hexafraction/tencent/tencm.kicad_pcb

## KiCad design tencm.kicad_pcb (2017-06-22)

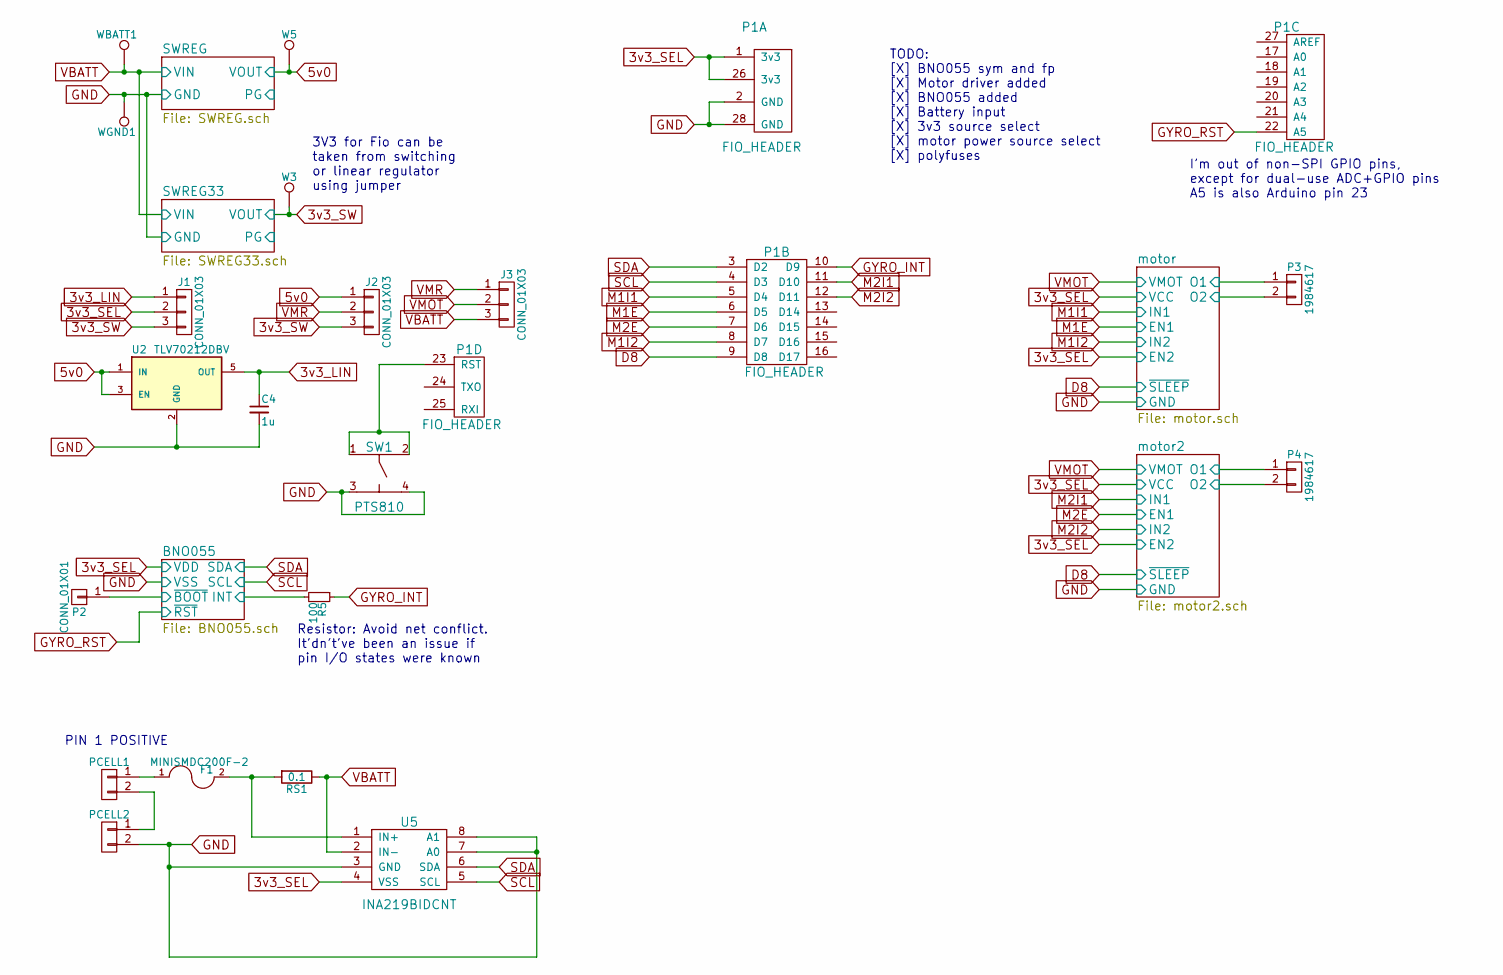
[picture p1: schematic tencm.sch]

Parts:
C4: 1u; C_0603
F1: MINISMDC200F-2; R_1812_HandSoldering
J1, J2, J3: CONN_01X03; Pin_Header_Straight_1x03
P1: FIO_HEADER; FIO_DIP
P2: CONN_01X01; Pin_Header_Straight_1x01
P3, P4: 1984617; TerminalBlock_Pheonix_PT-3.5mm_2pol
PCELL1, PCELL2: S2B-PH-K-S(LF)(SN); Connectors_JST_S2B-PH-K
R5: 100; R_0603
RS1: 0.1; MF_Passives-R1206
SW1: PTS810; BTN_PTS_810
U2: TLV70212DBV; MF_IC_Power-SOT-23-5
U5: INA219BIDCNT; sot23-8
W3, W5: TEST_1P; Measurement_Point_Round-TH_Small
WBATT1: TEST_1P; Measurement_Point_Round-TH_Small
WGND1: TEST_1P; Measurement_Point_Round-TH_Small

Connections:
3v3_LIN: C4.1, J1.1, U2.5 (OUT)
3v3_SEL: J1.2, P1.1 (3v3), P1.26 (3v3), U5.4 (VSS); also elsewhere on the board
3v3_SW: J1.3, J2.3, W3.1; also elsewhere on the board
5v0: J2.1, U2.1 (IN), U2.3 (EN), W5.1; also elsewhere on the board
/BNO055/INT: R5.2; also elsewhere on the board
/BNO055/~BOOT: P2.1; also elsewhere on the board
/motor2/O1: P4.1; also elsewhere on the board
/motor2/O2: P4.2; also elsewhere on the board
/motor/O1: P3.1; also elsewhere on the board
/motor/O2: P3.2; also elsewhere on the board
D8: P1.9 (D8); also elsewhere on the board
GGND: C4.2, P1.2 (GND), P1.28 (GND), PCELL2.2, SW1.3, SW1.4, U2.2 (GND), U5.3 (GND), U5.7 (A0), U5.8 (A1), WGND1.1; also elsewhere on the board
GRST: P1.22 (A5); also elsewhere on the board
GYRO_INT: P1.10 (D9), R5.1
M1E: P1.6 (D5); also elsewhere on the board
M1I1: P1.5 (D4); also elsewhere on the board
M1I2: P1.8 (D7); also elsewhere on the board
M2E: P1.7 (D6); also elsewhere on the board
M2I1: P1.11 (D10); also elsewhere on the board
M2I2: P1.12 (D11); also elsewhere on the board
unnamed: F1.1, PCELL1.1
unnamed: F1.2, RS1.2, U5.1 (IN+)
unnamed: P1.23 (RST), SW1.1, SW1.2
unnamed: PCELL1.2, PCELL2.1
SCL: P1.4 (D3), U5.5 (SCL); also elsewhere on the board
SDA: P1.3 (D2), U5.6 (SDA); also elsewhere on the board
VBATT: J3.3, RS1.1, U5.2 (IN-), WBATT1.1; also elsewhere on the board
VMOT: J3.2; also elsewhere on the board
VMR: J2.2, J3.1

Notes on the sheet:
3V3 for Fio can be taken from switching or linear regulator using jumper
TODO: [X] BNO055 sym and fp [X] Motor driver added [X] BNO055 added [X] Battery input [X] 3v3 source select [X] motor power source select [X] polyfuses
Resistor: Avoid net conflict. It'dn't've been an issue if pin I/O states were known
PIN 1 POSITIVE
I'm out of non-SPI GPIO pins, except for dual-use ADC+GPIO pins A5 is also Arduino pin 23

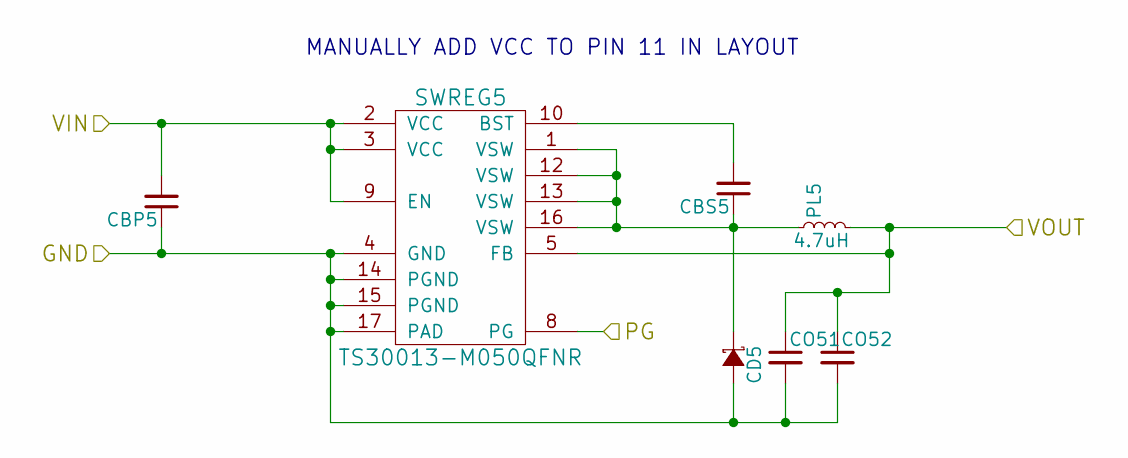
[picture p2: schematic SWREG.sch]

Parts:
CBP5: GMK316F106ZL-T; C_1206
CBS5: GMK316F106ZL-T; C_1206
CD5: PMEG4050EP; SOD128
CO51, CO52: CC0603MRX5R5BB226; C_0603
PL5: 4.7uH; L_5040
SWREG5: TS30013-M050QFNR; QFN16_TS30013

Connections:
5v0: CO51.1, CO52.1, PL5.2, SWREG5.5 (FB); also elsewhere on the board
/SWREG/PG: SWREG5.8 (PG)
GGND: CBP5.1, CD5.2 (A), CO51.2, CO52.2, SWREG5.4 (GND), SWREG5.14 (PGND), SWREG5.15 (PGND), SWREG5.17 (PAD); also elsewhere on the board
unnamed: CBS5.1, CD5.1 (K), PL5.1, SWREG5.1 (VSW), SWREG5.12 (VSW), SWREG5.13 (VSW), SWREG5.16 (VSW)
unnamed: CBS5.2, SWREG5.10 (BST)
VBATT: CBP5.2, SWREG5.2 (VCC), SWREG5.3 (VCC), SWREG5.9 (EN), SWREG5.11; also elsewhere on the board

Notes on the sheet:
MANUALLY ADD VCC TO PIN 11 IN LAYOUT

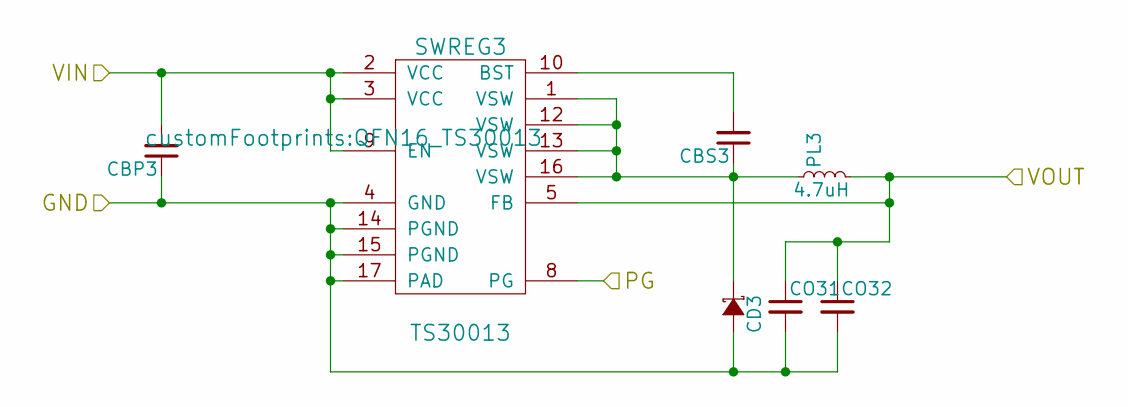
[picture p3: schematic SWREG33.sch]

Parts:
CBP3: GMK316F106ZL-T; C_1206
CBS3: GMK316F106ZL-T; C_1206
CD3: PMEG4050EP; SOD128
CO31, CO32: CC0603MRX5R5BB226; C_0603
PL3: 4.7uH; L_5040
SWREG3: TS30013; QFN16_TS30013

Connections:
3v3_SW: CO31.1, CO32.1, PL3.2, SWREG3.5 (FB); also elsewhere on the board
/SWREG33/PG: SWREG3.8 (PG)
GGND: CBP3.1, CD3.2 (A), CO31.2, CO32.2, SWREG3.4 (GND), SWREG3.14 (PGND), SWREG3.15 (PGND), SWREG3.17 (PAD); also elsewhere on the board
unnamed: CBS3.1, CD3.1 (K), PL3.1, SWREG3.1 (VSW), SWREG3.12 (VSW), SWREG3.13 (VSW), SWREG3.16 (VSW)
unnamed: CBS3.2, SWREG3.10 (BST)
VBATT: CBP3.2, SWREG3.2 (VCC), SWREG3.3 (VCC), SWREG3.9 (EN), SWREG3.11; also elsewhere on the board

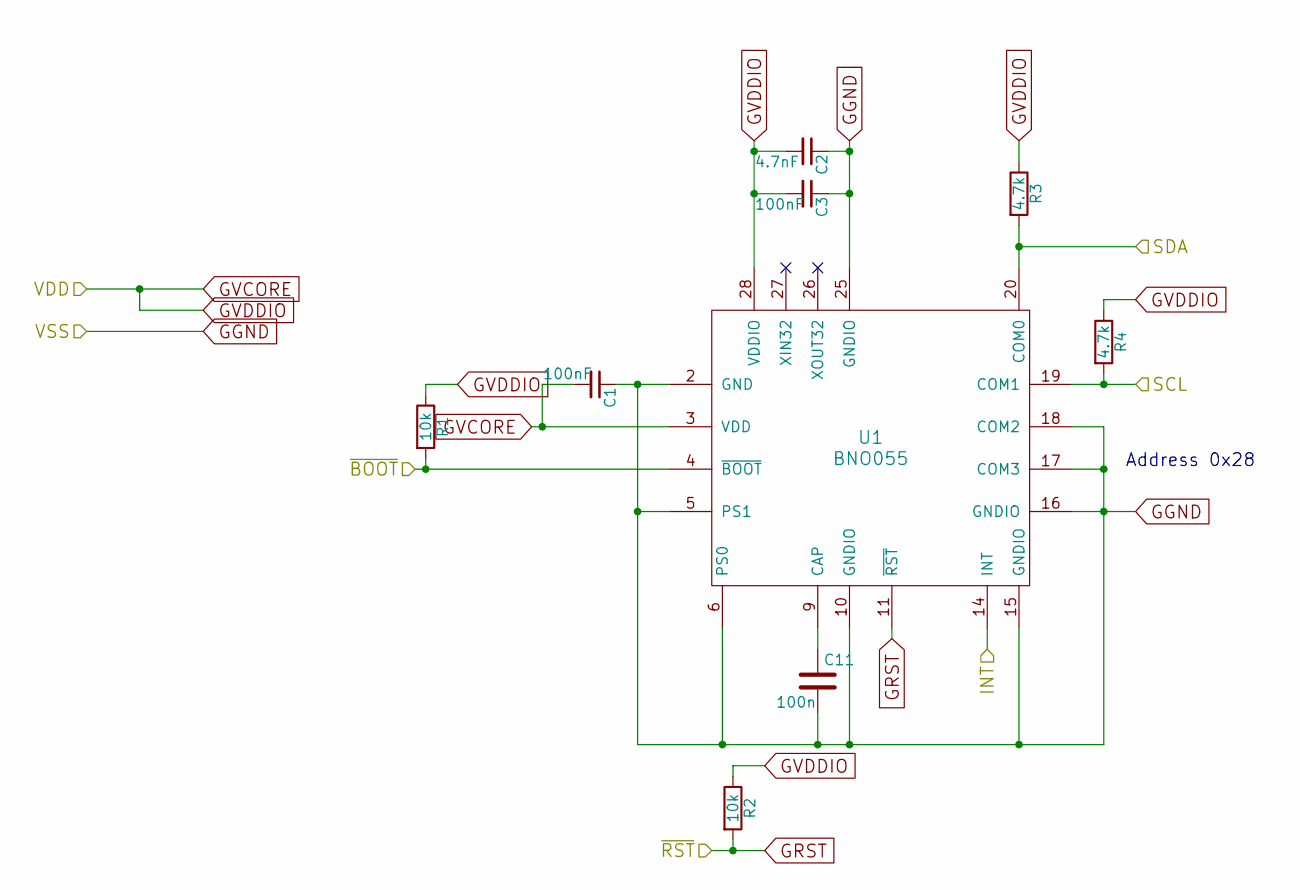
[picture p4: schematic BNO055.sch]

Parts:
C1, C3: 100nF; C_0603
C2: 4.7nF; C_0603
C11: 100n; C_0603
R1, R2: 10k; R_0603
R3, R4: 4.7k; R_0603
U1: BNO055; BNO055-SOIC

Connections:
3v3_SEL: C1.2, C2.2, C3.2, R1.1, R2.1, R3.1, R4.1, U1.3 (VDD), U1.28 (VDDIO); also elsewhere on the board
/BNO055/INT: U1.14 (INT); also elsewhere on the board
/BNO055/~BOOT: R1.2, U1.4 (~BOOT); also elsewhere on the board
GGND: C1.1, C2.1, C3.1, C11.2, U1.2 (GND), U1.5 (PS1), U1.6 (PS0), U1.10 (GNDIO), U1.15 (GNDIO), U1.16 (GNDIO), U1.17 (COM3), U1.18 (COM2), U1.25 (GNDIO); also elsewhere on the board
GRST: R2.2, U1.11 (~RST); also elsewhere on the board
unnamed: C11.1, U1.9 (CAP)
SCL: R4.2, U1.19 (COM1); also elsewhere on the board
SDA: R3.2, U1.20 (COM0); also elsewhere on the board

Notes on the sheet:
Address 0x28

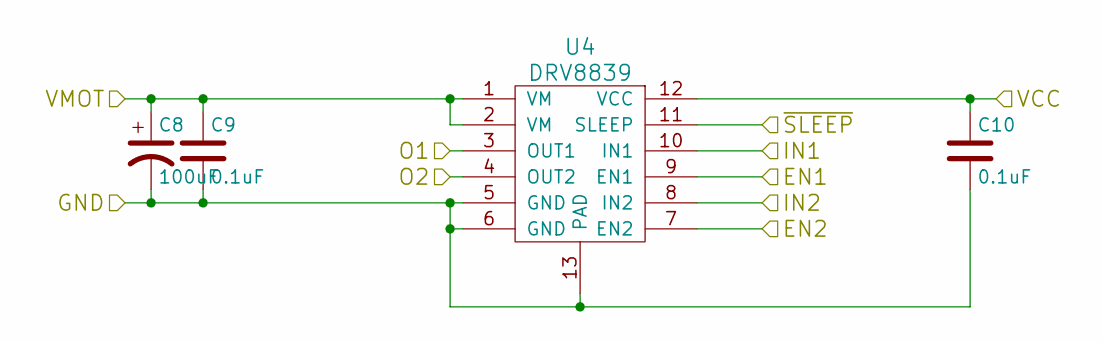
[picture p5: schematic motor2.sch]

Parts:
C8: 100uF; c_elec_5x5.3
C9, C10: 0.1uF; C_0603
U4: DRV8839; SOIC-12-DRV8839

Connections:
3v3_SEL: C10.1, U4.7 (EN2), U4.12 (VCC); also elsewhere on the board
/motor2/O1: U4.3 (OUT1); also elsewhere on the board
/motor2/O2: U4.4 (OUT2); also elsewhere on the board
D8: U4.11 (SLEEP); also elsewhere on the board
GGND: C8.2, C9.2, C10.2, U4.5 (GND), U4.6 (GND), U4.13 (PAD); also elsewhere on the board
M2E: U4.9 (EN1); also elsewhere on the board
M2I1: U4.10 (IN1); also elsewhere on the board
M2I2: U4.8 (IN2); also elsewhere on the board
VMOT: C8.1, C9.1, U4.1 (VM), U4.2 (VM); also elsewhere on the board

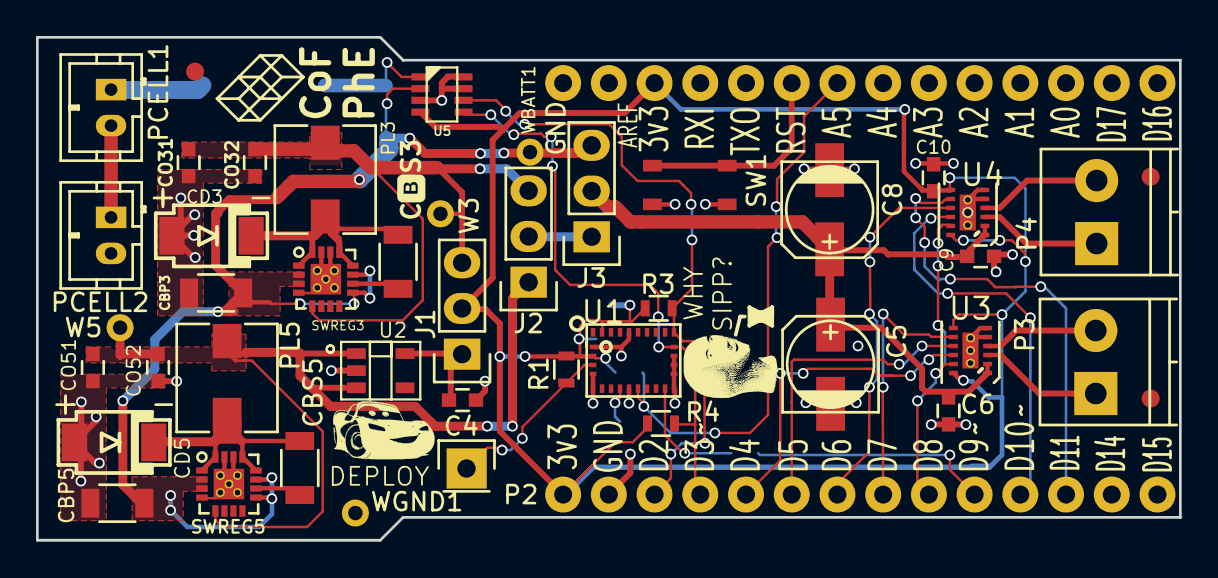
[picture p6: board tencm.kicad_pcb from above]

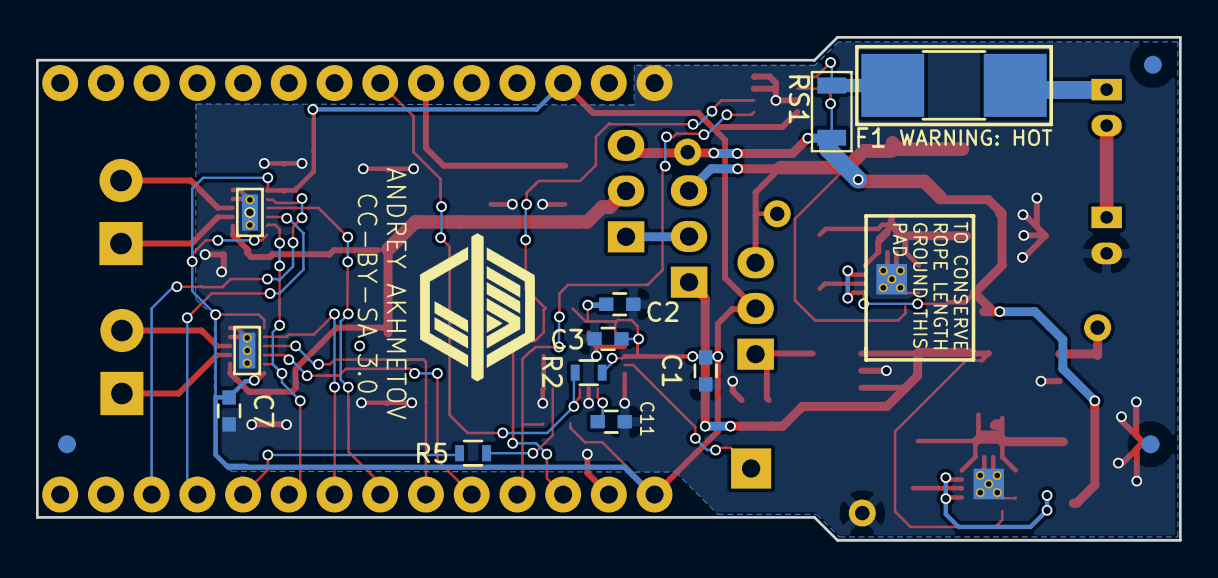
[picture p7: board tencm.kicad_pcb from below]

Board: 2 copper layers, 63.5 x 27.9 mm, 57 parts (12 on the bottom side), 34 nets.

Other parts of the board:
C5: 100uF; c_elec_5x5.3
C6, C7: 0.1uF; C_0603
FID1, FID2, FID3, FID4, FID5, FID6: Fiducial_1mm_Dia_2.54mm_Outer_CopperTop
U3: DRV8839; SOIC-12-DRV8839

Their connections:
3v3_SEL: C7.1, U3.7, U3.12; also elsewhere on the board
/motor/O1: U3.3; also elsewhere on the board
/motor/O2: U3.4; also elsewhere on the board
D8: U3.11; also elsewhere on the board
GGND: C5.2, C6.2, C7.2, U3.5, U3.6, U3.13; also elsewhere on the board
M1E: U3.9; also elsewhere on the board
M1I1: U3.10; also elsewhere on the board
M1I2: U3.8; also elsewhere on the board
VMOT: C5.1, C6.1, U3.1, U3.2; also elsewhere on the board
