hexafraction/tencent/(commit log)

2017-06-13 Initial commit.
    [tencm.kicad_pcb, tencm.sch]
2017-06-18 lots of work on schematic
    [BNO055.sch, SWREG.sch, SWREG33.sch, SWREG33OLD.sch, motor.sch, tencm.kicad_pcb, tencm.sch]
2017-06-19 initiial layout
    [BNO055.sch, SWREG.sch, SWREG33.sch, motor2.sch, tencm.kicad_pcb, tencm.sch]
2017-06-22 board v1
    [tencm.kicad_pcb, tencm2.kicad_pcb]
