hexafraction/tencent/(notices)

Notices in the files:
tencm.kicad_pcb:
CC-BY-SA 3.0
